sigmondkukla/rp2040-programmer-calculator/pcb/rp2040-programmer-calculator/rp2040-programmer-calculator.kicad_pcb

## KiCad design pcb/rp2040-programmer-calculator/rp2040-programmer-calculator.kicad_pcb (2025-03-18)

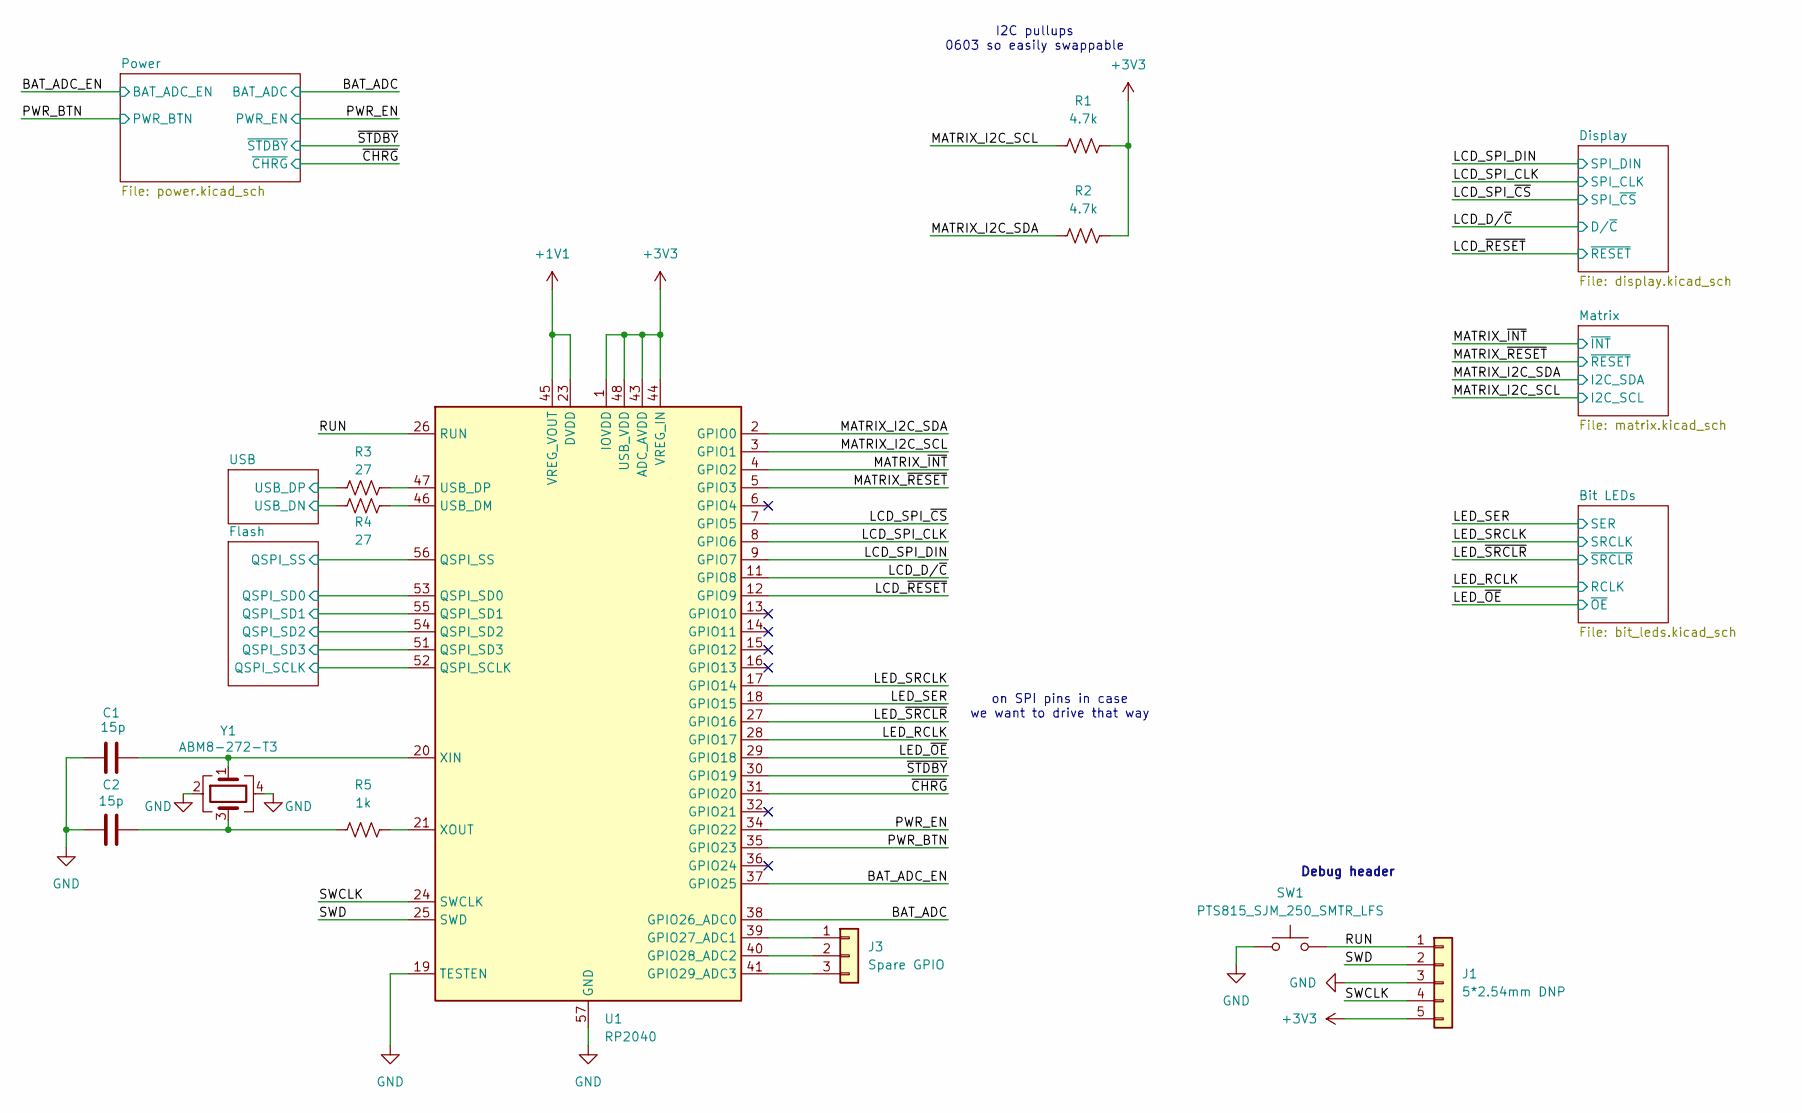
[picture p1: schematic rp2040-programmer-calculator.kicad_sch]

Parts:
C1, C2: 15p; C_0402_1005Metric; LCSC C1548
J1: 5*2.54mm DNP; PinHeader_1x05_P2.54mm_Vertical
J3: Spare GPIO; PinHeader_1x03_P2.00mm_Vertical
R1, R2: 4.7k; R_0603_1608Metric
R3, R4: 27; R_0402_1005Metric
R5: 1k; R_0402_1005Metric
SW1: PTS815_SJM_250_SMTR_LFS; SW_Push_PTS815_SJM_250_SMTR_LFS
U1: RP2040; QFN-56-1EP_7x7mm_P0.4mm_EP3.2x3.2mm
Y1: ABM8-272-T3; Crystal_SMD_Abracon_ABM8G-4Pin_3.2x2.5mm; LCSC C20625731

Connections:
+1V1: U1.23 (DVDD), U1.45 (VREG_VOUT), U1.50 (DVDD); also elsewhere on the board
+3V3: J1.5, R1.2, R2.2, U1.1 (IOVDD), U1.10 (IOVDD), U1.22 (IOVDD), U1.33 (IOVDD), U1.42 (IOVDD), U1.43 (ADC_AVDD), U1.44 (VREG_IN), U1.48 (USB_VDD), U1.49 (IOVDD); also elsewhere on the board
/BAT_ADC: U1.38 (GPIO26_ADC0); also elsewhere on the board
/BAT_ADC_EN: U1.37 (GPIO25); also elsewhere on the board
/Flash/QSPI_SCLK: U1.52 (QSPI_SCLK); also elsewhere on the board
/Flash/QSPI_SD0: U1.53 (QSPI_SD0); also elsewhere on the board
/Flash/QSPI_SD1: U1.55 (QSPI_SD1); also elsewhere on the board
/Flash/QSPI_SD2: U1.54 (QSPI_SD2); also elsewhere on the board
/Flash/QSPI_SD3: U1.51 (QSPI_SD3); also elsewhere on the board
/Flash/QSPI_SS: U1.56 (QSPI_SS); also elsewhere on the board
/LCD_D/~C: U1.11 (GPIO8); also elsewhere on the board
/LCD_SPI_CLK: U1.8 (GPIO6); also elsewhere on the board
/LCD_SPI_DIN: U1.9 (GPIO7); also elsewhere on the board
/LCD_SPI_~CS: U1.7 (GPIO5); also elsewhere on the board
/LCD_~RESET: U1.12 (GPIO9); also elsewhere on the board
/LED_RCLK: U1.28 (GPIO17); also elsewhere on the board
/LED_SER: U1.18 (GPIO15); also elsewhere on the board
/LED_SRCLK: U1.17 (GPIO14); also elsewhere on the board
/LED_~OE: U1.29 (GPIO18); also elsewhere on the board
/LED_~SRCLR: U1.27 (GPIO16); also elsewhere on the board
/MATRIX_I2C_SCL: R1.1, U1.3 (GPIO1); also elsewhere on the board
/MATRIX_I2C_SDA: R2.1, U1.2 (GPIO0); also elsewhere on the board
/MATRIX_~INT: U1.4 (GPIO2); also elsewhere on the board
/MATRIX_~RESET: U1.5 (GPIO3); also elsewhere on the board
/PWR_BTN: U1.35 (GPIO23); also elsewhere on the board
/PWR_EN: U1.34 (GPIO22); also elsewhere on the board
/RUN: J1.1, SW1.2, U1.26 (RUN)
/SWCLK: J1.4, U1.24 (SWCLK)
/SWD: J1.2, U1.25 (SWD)
/USB/USB_DN: R4.1; also elsewhere on the board
/USB/USB_DP: R3.1; also elsewhere on the board
/~CHRG: U1.31 (GPIO20); also elsewhere on the board
/~STDBY: U1.30 (GPIO19); also elsewhere on the board
GND: C1.1, C2.1, J1.3, SW1.1, U1.19 (TESTEN), U1.57 (GND), Y1.2, Y1.4; also elsewhere on the board
unnamed: C2.2, R5.1, Y1.3
unnamed: J3.1, U1.39 (GPIO27_ADC1)
unnamed: J3.2, U1.40 (GPIO28_ADC2)
unnamed: J3.3, U1.41 (GPIO29_ADC3)
unnamed: R4.2, U1.46 (USB_DM)
unnamed: R3.2, U1.47 (USB_DP)
unnamed: C1.2, U1.20 (XIN), Y1.1
unnamed: R5.2, U1.21 (XOUT)

Notes on the sheet:
I2C pullups 0603 so easily swappable
on SPI pins in case we want to drive that way
Debug header

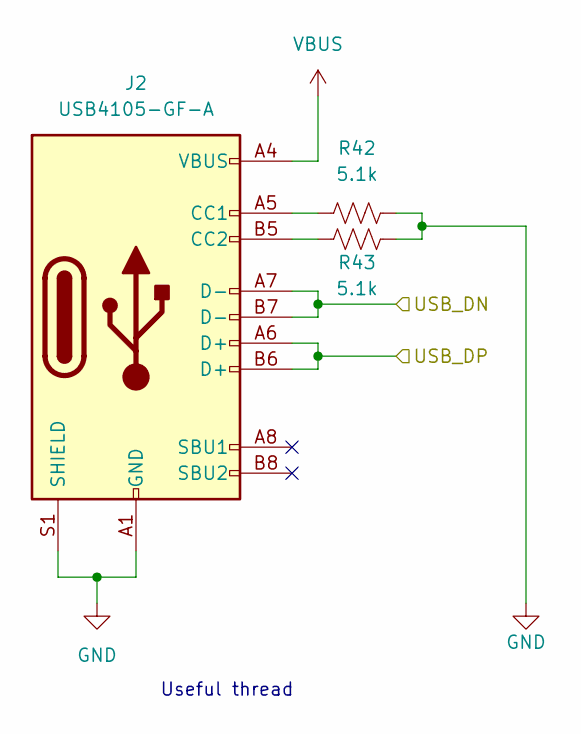
[picture p2: schematic usb.kicad_sch]

Parts:
J2: USB4105-GF-A; USB_C_Receptacle_GCT_USB4105-xx-A_16P_TopMnt_Horizontal
R42, R43: 5.1k; R_0603_1608Metric

Connections:
/USB/USB_DN: J2.A7 (D-), J2.B7 (D-); also elsewhere on the board
/USB/USB_DP: J2.A6 (D+), J2.B6 (D+); also elsewhere on the board
GND: J2.A1 (GND), J2.A12 (GND), J2.B1 (GND), J2.B12 (GND), J2.S1 (SHIELD), R42.2, R43.2; also elsewhere on the board
unnamed: J2.A5 (CC1), R42.1
unnamed: J2.B5 (CC2), R43.1
VBUS: J2.A4 (VBUS), J2.A9 (VBUS), J2.B4 (VBUS), J2.B9 (VBUS); also elsewhere on the board

Notes on the sheet:
Useful thread

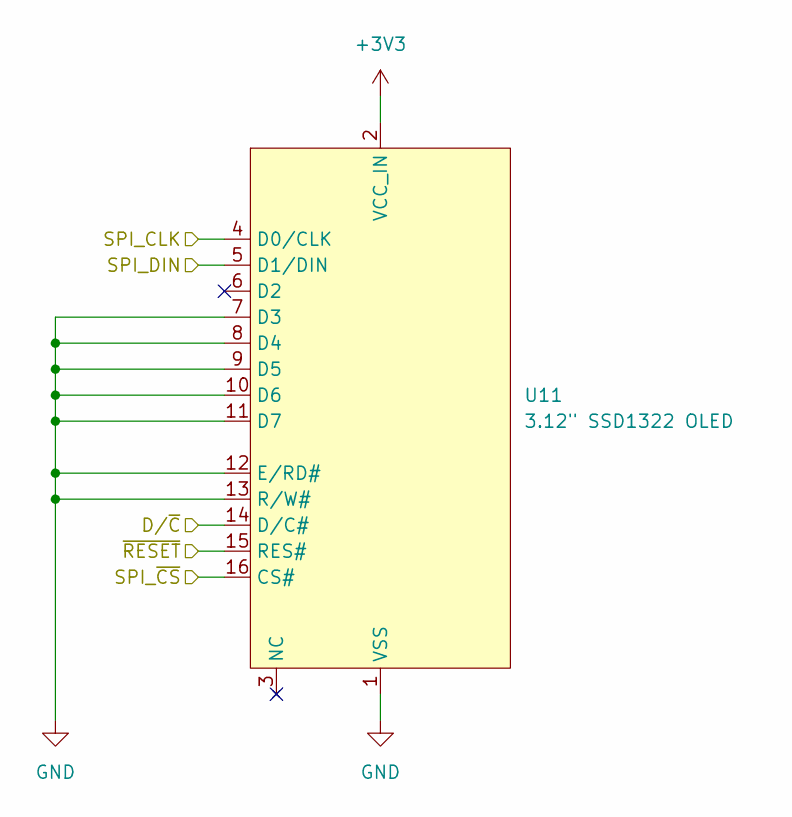
[picture p3: schematic display.kicad_sch]

Parts:
U11: 3.12" SSD1322 OLED; SSD1322_OLED

Connections:
+3V3: U11.2 (VCC_IN); also elsewhere on the board
/LCD_D/~C: U11.14 (D/C#); also elsewhere on the board
/LCD_SPI_CLK: U11.4 (D0/CLK); also elsewhere on the board
/LCD_SPI_DIN: U11.5 (D1/DIN); also elsewhere on the board
/LCD_SPI_~CS: U11.16 (CS#); also elsewhere on the board
/LCD_~RESET: U11.15 (RES#); also elsewhere on the board
GND: U11.1 (VSS), U11.7 (D3), U11.8 (D4), U11.9 (D5), U11.10 (D6), U11.11 (D7), U11.12 (E/RD#), U11.13 (R/W#); also elsewhere on the board

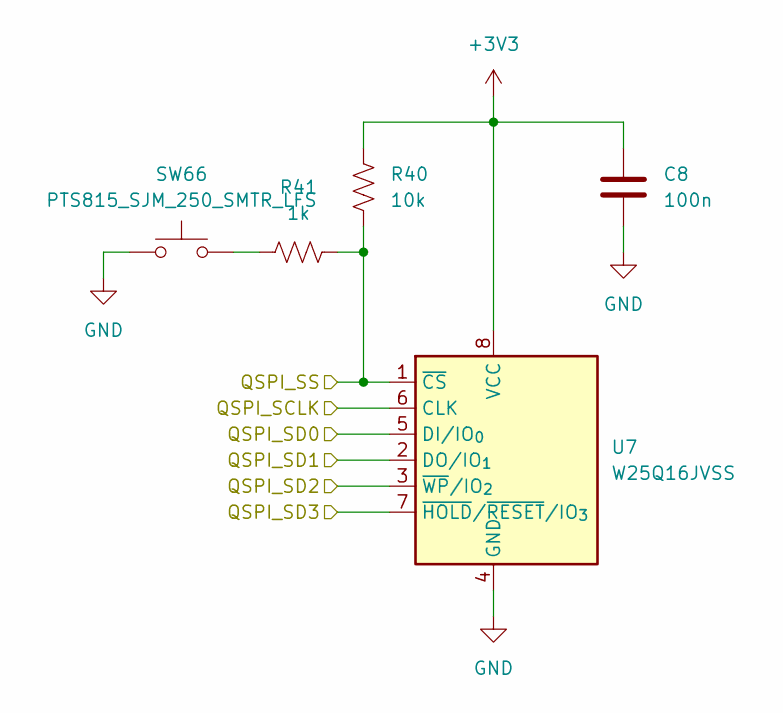
[picture p4: schematic flash.kicad_sch]

Parts:
C8: 100n; C_0603_1608Metric
R40: 10k; R_0603_1608Metric
R41: 1k; R_0603_1608Metric
SW66: PTS815_SJM_250_SMTR_LFS; SW_Push_PTS815_SJM_250_SMTR_LFS
U7: W25Q16JVSS; SOIC-8_5.3x5.3mm_P1.27mm

Connections:
+3V3: C8.1, R40.1, U7.8 (VCC); also elsewhere on the board
/Flash/QSPI_SCLK: U7.6 (CLK); also elsewhere on the board
/Flash/QSPI_SD0: U7.5 (DI/IO_{0}); also elsewhere on the board
/Flash/QSPI_SD1: U7.2 (DO/IO_{1}); also elsewhere on the board
/Flash/QSPI_SD2: U7.3 (~WP/IO_{2}); also elsewhere on the board
/Flash/QSPI_SD3: U7.7 (~HOLD/~RESET/IO_{3}); also elsewhere on the board
/Flash/QSPI_SS: R40.2, R41.2, U7.1 (~CS); also elsewhere on the board
GND: C8.2, SW66.1, U7.4 (GND); also elsewhere on the board
unnamed: R41.1, SW66.2

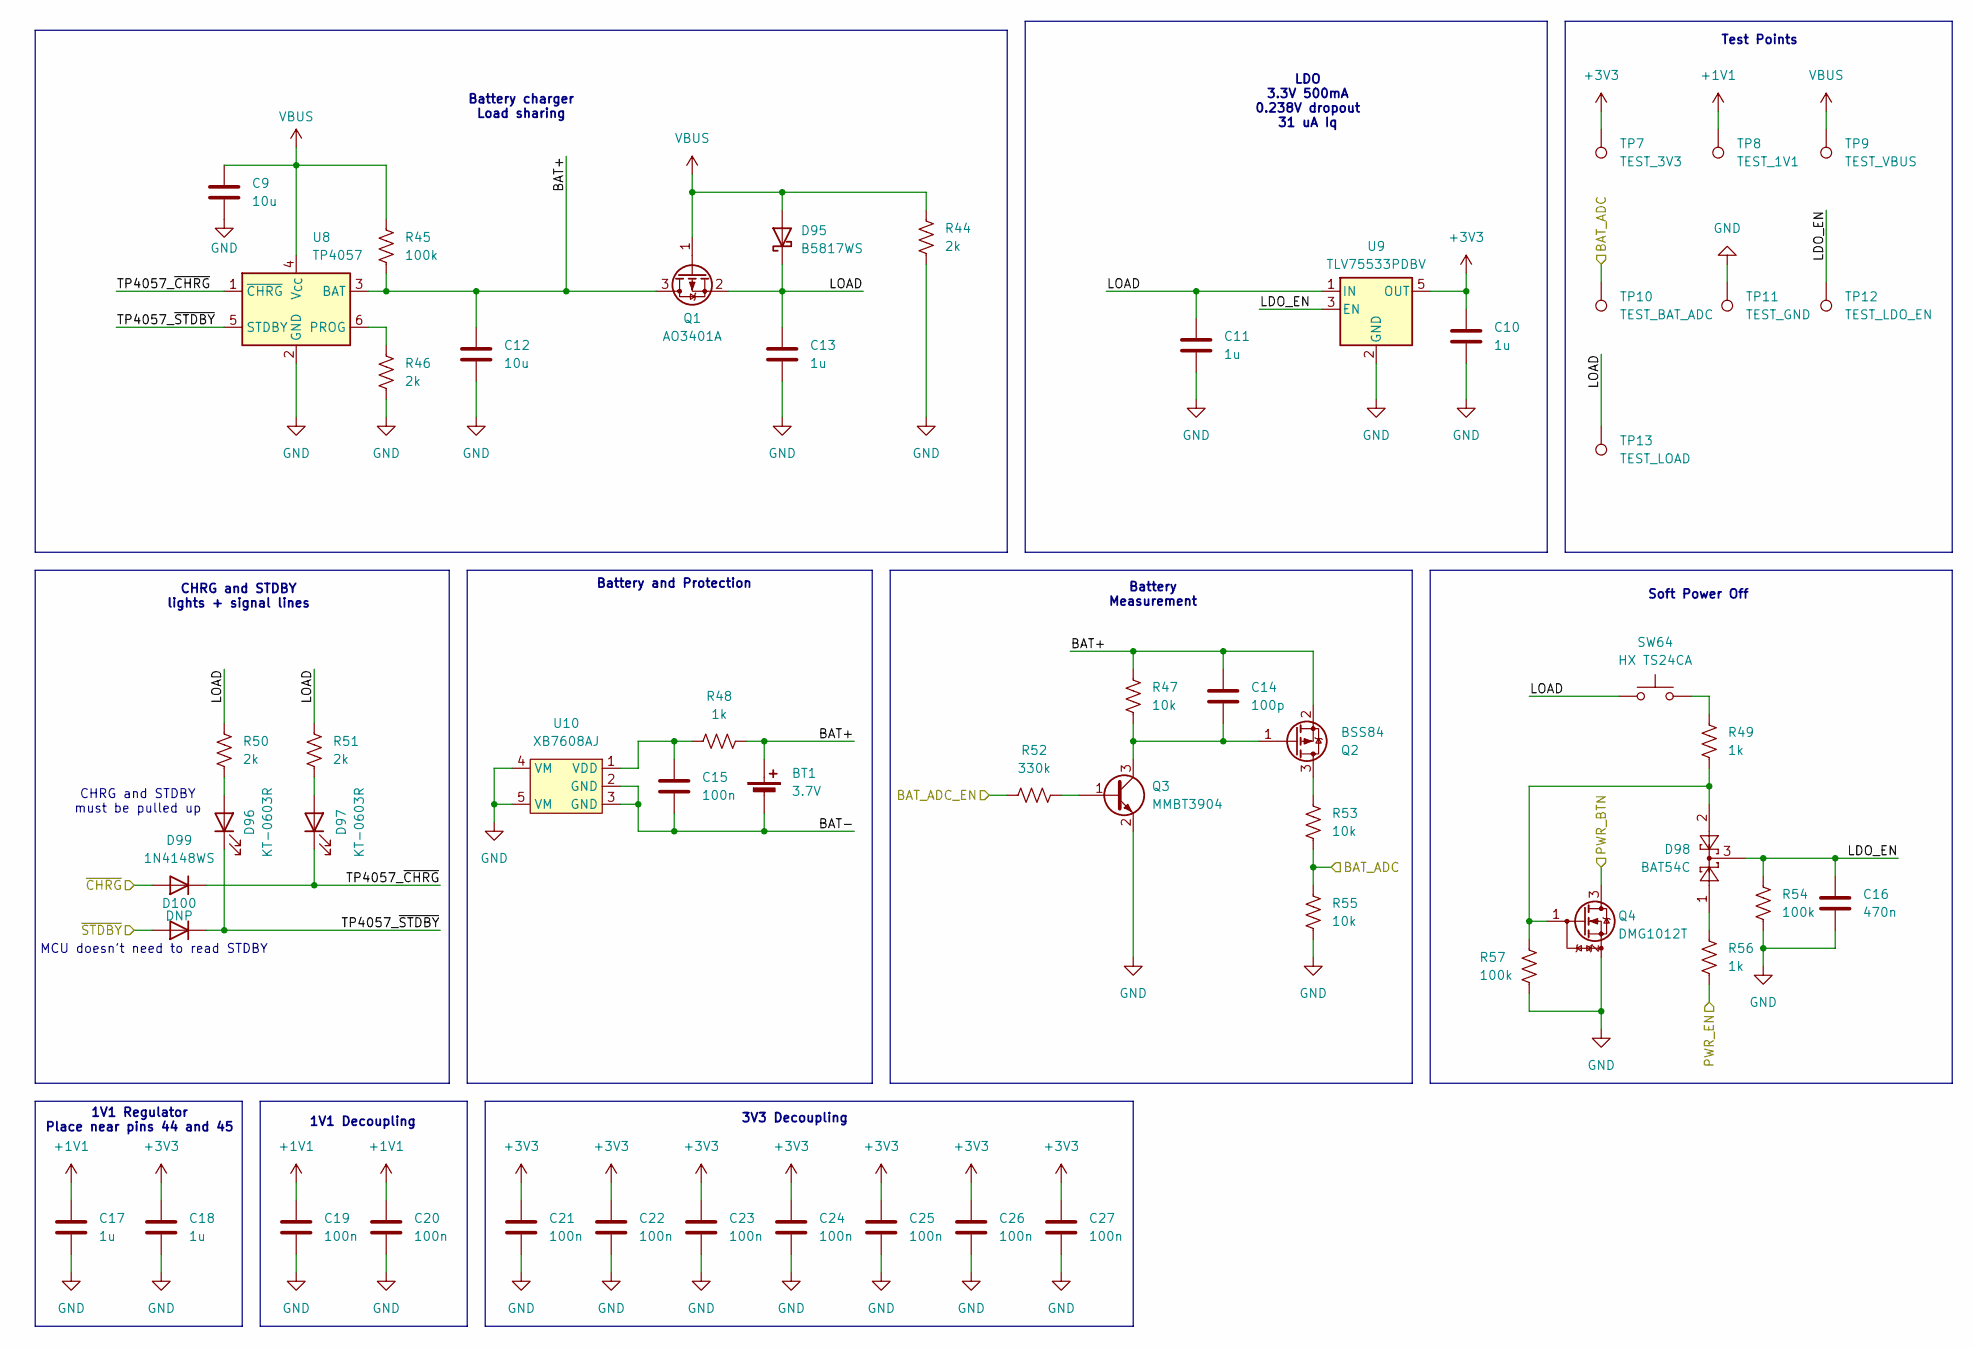
[picture p5: schematic power.kicad_sch]

Parts:
BT1: 3.7V; JST_PH_S2B-PH-K_1x02_P2.00mm_Horizontal
C9, C12: 10u; C_0603_1608Metric
C10, C11: 1u; C_0603_1608Metric; LCSC C52923
C13: 1u; C_0603_1608Metric
C14: 100p; C_0603_1608Metric
C15: 100n; C_0603_1608Metric
C16: 470n; C_0603_1608Metric
C17, C18: 1u; C_0402_1005Metric; LCSC C52923
C19, C20, C21, C22, C23, C24, C25, C26, C27: 100n; C_0402_1005Metric; LCSC C1525
D95: B5817WS; D_SOD-323
D96, D97: KT-0603R; LED_0603_1608Metric
D98: BAT54C; SOT-23-3
D99: 1N4148WS; D_SOD-323
D100: DNP; D_SOD-323
Q1: AO3401A; SOT-23-3
Q2: BSS84; SOT-23-3
Q3: MMBT3904; SOT-23
Q4: DMG1012T; SOT-523
R44, R46, R50, R51: 2k; R_0603_1608Metric
R45, R54, R57: 100k; R_0603_1608Metric
R47, R53, R55: 10k; R_0603_1608Metric
R48, R49, R56: 1k; R_0603_1608Metric
R52: 330k; R_0603_1608Metric
SW64: HX TS24CA; HX-TS24CA
TP7: TEST_3V3; TestPoint_Pad_D1.0mm
TP8: TEST_1V1; TestPoint_Pad_D1.0mm
TP9: TEST_VBUS; TestPoint_Pad_D1.0mm
TP10: TEST_BAT_ADC; TestPoint_Pad_D1.0mm
TP11: TEST_GND; TestPoint_Pad_D1.0mm
TP12: TEST_LDO_EN; TestPoint_Pad_D1.0mm
TP13: TEST_LOAD; TestPoint_Pad_D1.0mm
U8: TP4057; TSOT-23-6
U9: TLV75533PDBV; SOT-23-5
U10: XB7608AJ; CPC-5_L2.6-W2.6-P0.53-LS4.0-BL

Connections:
+1V1: C17.1, C19.1, C20.1, TP8.1; also elsewhere on the board
+3V3: C10.1, C18.1, C21.1, C22.1, C23.1, C24.1, C25.1, C26.1, C27.1, TP7.1, U9.5 (OUT); also elsewhere on the board
/BAT_ADC: R53.1, R55.2, TP10.1; also elsewhere on the board
/BAT_ADC_EN: R52.1; also elsewhere on the board
/PWR_BTN: Q4.3 (D); also elsewhere on the board
/PWR_EN: R56.2; also elsewhere on the board
/Power/BAT+: BT1.1 (+), C12.1, C14.1, Q1.3 (D), Q2.2 (S), R45.2, R47.2, R48.2, U8.3 (BAT)
/Power/BAT-: BT1.2 (-), C15.2, U10.2 (GND), U10.3 (GND)
/Power/LDO_EN: C16.1, D98.3, R54.1, TP12.1, U9.3 (EN)
/Power/LOAD: C11.1, C13.1, D95.1 (K), Q1.2 (S), R50.1, R51.1, SW64.2, TP13.1, U9.1 (IN)
/Power/TP4057_~CHRG: D97.1 (K), D99.1 (K), U8.1 (~CHRG)
/Power/TP4057_~STDBY: D96.1 (K), D100.1 (K), U8.5 (STDBY)
/~CHRG: D99.2 (A); also elsewhere on the board
/~STDBY: D100.2 (A); also elsewhere on the board
GND: C9.2, C10.2, C11.2, C12.2, C13.2, C16.2, C17.2, C18.2, C19.2, C20.2, C21.2, C22.2, C23.2, C24.2, C25.2, C26.2, C27.2, Q3.2 (E), Q4.2 (S), R44.2, R46.2, R54.2, R55.1, R57.2, TP11.1, U8.2 (GND), U9.2 (GND), U10.4 (VM), U10.5 (VM); also elsewhere on the board
unnamed: D96.2 (A), R50.2
unnamed: D97.2 (A), R51.2
unnamed: D98.1, R56.1
unnamed: Q2.3 (D), R53.2
unnamed: C14.2, Q2.1 (G), Q3.3 (C), R47.1
unnamed: Q3.1 (B), R52.2
unnamed: D98.2, Q4.1 (G), R49.2, R57.1
unnamed: R49.1, SW64.1
unnamed: R46.1, U8.6 (PROG)
unnamed: C15.1, R48.1, U10.1 (VDD)
VBUS: C9.1, D95.2 (A), Q1.1 (G), R44.1, R45.1, TP9.1, U8.4 (V_{CC}); also elsewhere on the board

Notes on the sheet:
MCU doesn't need to read STDBY
Battery Measurement
CHRG and STDBY lights + signal lines
CHRG and STDBY must be pulled up
LDO 3.3V 500mA 0.238V dropout 31 uA Iq
Test Points
3V3 Decoupling
Battery charger Load sharing
Soft Power Off
Battery and Protection
1V1 Regulator Place near pins 44 and 45
1V1 Decoupling

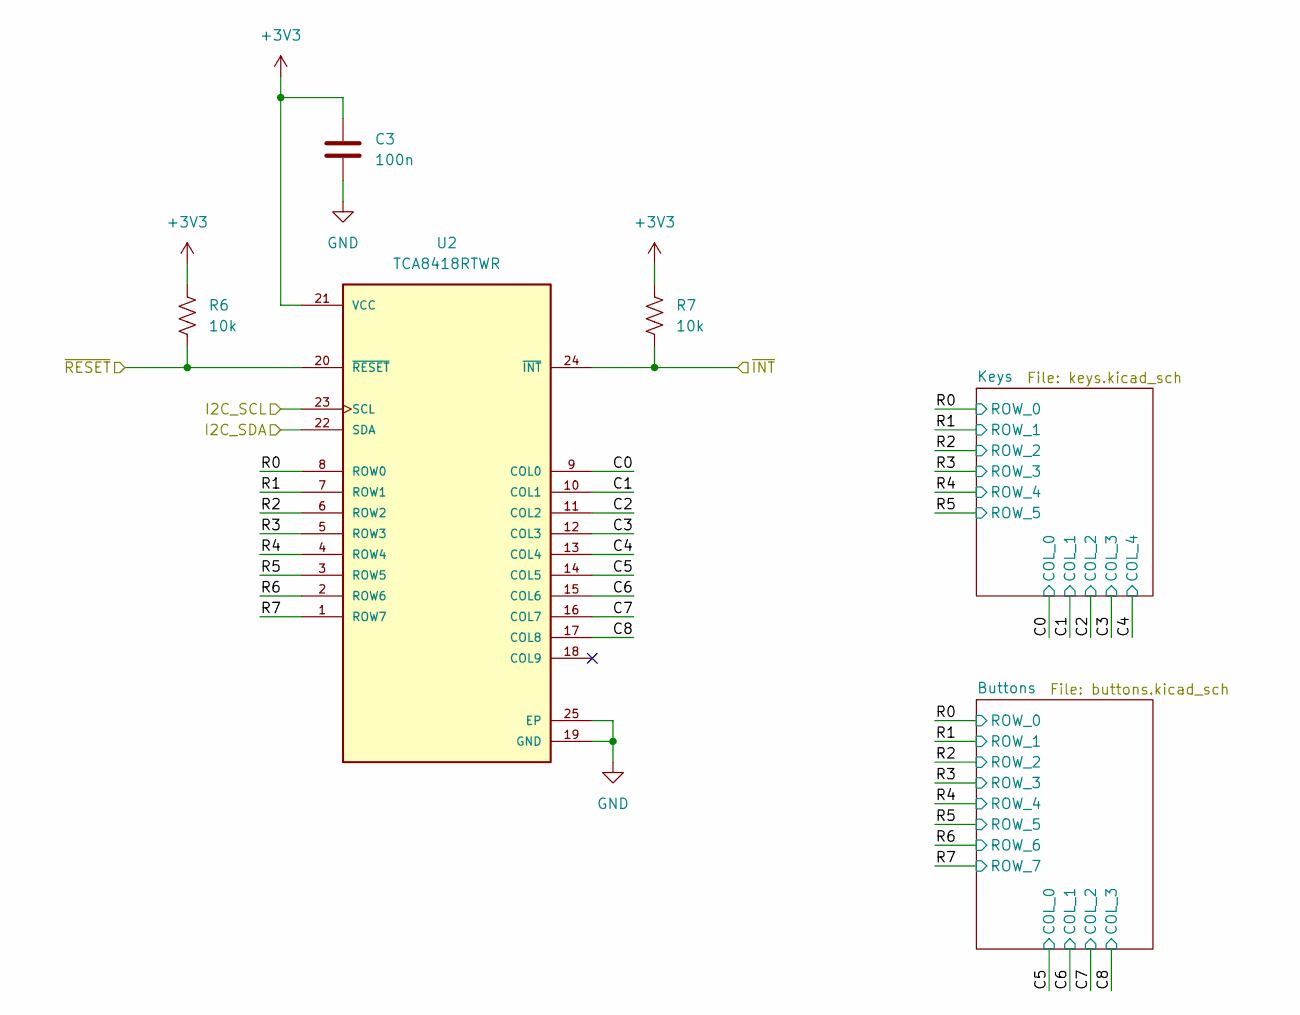
[picture p6: schematic matrix.kicad_sch]

Parts:
C3: 100n; C_0603_1608Metric
R6, R7: 10k; R_0603_1608Metric
U2: TCA8418RTWR; QFN50P400X400X80-25N; PARTREV G

Connections:
+3V3: C3.1, R6.1, R7.1, U2.21 (VCC); also elsewhere on the board
/MATRIX_I2C_SCL: U2.23 (SCL); also elsewhere on the board
/MATRIX_I2C_SDA: U2.22 (SDA); also elsewhere on the board
/MATRIX_~INT: R7.2, U2.24 (~INT); also elsewhere on the board
/MATRIX_~RESET: R6.2, U2.20 (~RESET); also elsewhere on the board
/Matrix/C0: U2.9 (COL0); also elsewhere on the board
/Matrix/C1: U2.10 (COL1); also elsewhere on the board
/Matrix/C2: U2.11 (COL2); also elsewhere on the board
/Matrix/C3: U2.12 (COL3); also elsewhere on the board
/Matrix/C4: U2.13 (COL4); also elsewhere on the board
/Matrix/C5: U2.14 (COL5); also elsewhere on the board
/Matrix/C6: U2.15 (COL6); also elsewhere on the board
/Matrix/C7: U2.16 (COL7); also elsewhere on the board
/Matrix/C8: U2.17 (COL8); also elsewhere on the board
/Matrix/R0: U2.8 (ROW0); also elsewhere on the board
/Matrix/R1: U2.7 (ROW1); also elsewhere on the board
/Matrix/R2: U2.6 (ROW2); also elsewhere on the board
/Matrix/R3: U2.5 (ROW3); also elsewhere on the board
/Matrix/R4: U2.4 (ROW4); also elsewhere on the board
/Matrix/R5: U2.3 (ROW5); also elsewhere on the board
/Matrix/R6: U2.2 (ROW6); also elsewhere on the board
/Matrix/R7: U2.1 (ROW7); also elsewhere on the board
GND: C3.2, U2.19 (GND), U2.25 (EP); also elsewhere on the board

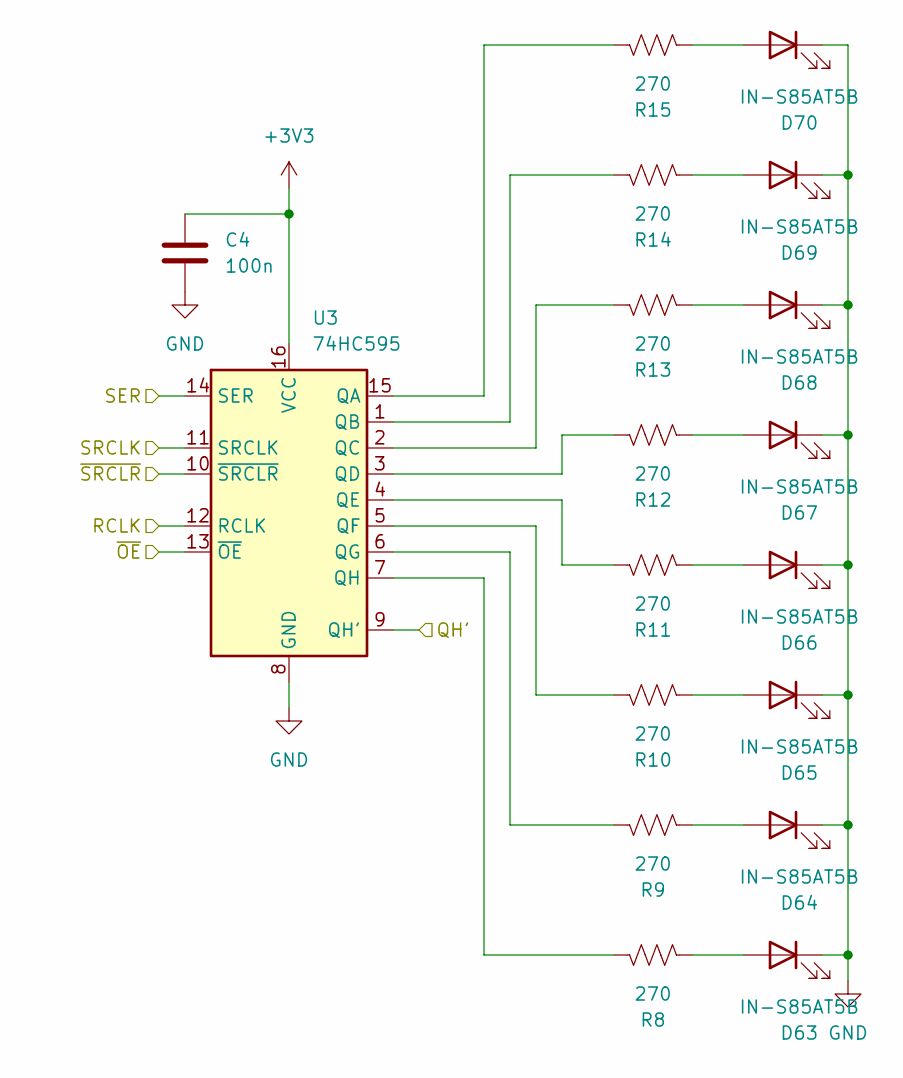
[picture p7: schematic led_byte.kicad_sch]

Parts:
C4: 100n; C_0603_1608Metric
D63, D64, D65, D66, D67, D68, D69, D70: IN-S85AT5B; LED_0805_2012Metric_Pad1.15x1.40mm_HandSolder
R8, R9, R10, R11, R12, R13, R14, R15: 270; R_0603_1608Metric_Pad0.98x0.95mm_HandSolder
U3: 74HC595; SOIC-16_3.9x9.9mm_P1.27mm

Connections:
+3V3: C4.1, U3.16 (VCC); also elsewhere on the board
/Bit LEDs/BYTE_0_OUT: U3.9 (QH'); also elsewhere on the board
/LED_RCLK: U3.12 (RCLK); also elsewhere on the board
/LED_SER: U3.14 (SER); also elsewhere on the board
/LED_SRCLK: U3.11 (SRCLK); also elsewhere on the board
/LED_~OE: U3.13 (~OE); also elsewhere on the board
/LED_~SRCLR: U3.10 (~SRCLR); also elsewhere on the board
GND: C4.2, D63.1 (K), D64.1 (K), D65.1 (K), D66.1 (K), D67.1 (K), D68.1 (K), D69.1 (K), D70.1 (K), U3.8 (GND); also elsewhere on the board
unnamed: D63.2 (A), R8.2
unnamed: D64.2 (A), R9.2
unnamed: D65.2 (A), R10.2
unnamed: D66.2 (A), R11.2
unnamed: D67.2 (A), R12.2
unnamed: D68.2 (A), R13.2
unnamed: D69.2 (A), R14.2
unnamed: D70.2 (A), R15.2
unnamed: R15.1, U3.15 (QA)
unnamed: R14.1, U3.1 (QB)
unnamed: R13.1, U3.2 (QC)
unnamed: R12.1, U3.3 (QD)
unnamed: R11.1, U3.4 (QE)
unnamed: R10.1, U3.5 (QF)
unnamed: R9.1, U3.6 (QG)
unnamed: R8.1, U3.7 (QH)

Parts of its further copies:
C5, C6, C7: 100n; C_0603_1608Metric
D71, D72, D73, D74, D75, D76, D77, D78, D79, D80, D81, D82, D83, D84, D85, D86, D87, D88, D89, D90, D91, D92, D93, D94: IN-S85AT5B; LED_0805_2012Metric_Pad1.15x1.40mm_HandSolder
R16, R17, R18, R19, R20, R21, R22, R23, R24, R25, R26, R27, R28, R29, R30, R31, R32, R33, R34, R35, R36, R37, R38, R39: 270; R_0603_1608Metric_Pad0.98x0.95mm_HandSolder
U4, U5, U6: 74HC595; SOIC-16_3.9x9.9mm_P1.27mm

Connections of its further copies:
+3V3: C5.1, C6.1, C7.1, U4.16 (VCC), U5.16 (VCC), U6.16 (VCC); also elsewhere on the board
/Bit LEDs/BYTE_0_OUT: U4.14 (SER); also elsewhere on the board
/Bit LEDs/BYTE_1_OUT: U4.9 (QH'), U5.14 (SER)
/Bit LEDs/BYTE_2_OUT: U5.9 (QH'), U6.14 (SER)
/Bit LEDs/LED_Byte_3/QH&apos;: U6.9 (QH')
/LED_RCLK: U4.12 (RCLK), U5.12 (RCLK), U6.12 (RCLK); also elsewhere on the board
/LED_SRCLK: U4.11 (SRCLK), U5.11 (SRCLK), U6.11 (SRCLK); also elsewhere on the board
/LED_~OE: U4.13 (~OE), U5.13 (~OE), U6.13 (~OE); also elsewhere on the board
/LED_~SRCLR: U4.10 (~SRCLR), U5.10 (~SRCLR), U6.10 (~SRCLR); also elsewhere on the board
GND: C5.2, C6.2, C7.2, D71.1 (K), D72.1 (K), D73.1 (K), D74.1 (K), D75.1 (K), D76.1 (K), D77.1 (K), D78.1 (K), D79.1 (K), D80.1 (K), D81.1 (K), D82.1 (K), D83.1 (K), D84.1 (K), D85.1 (K), D86.1 (K), D87.1 (K), D88.1 (K), D89.1 (K), D90.1 (K), D91.1 (K), D92.1 (K), D93.1 (K), D94.1 (K), U4.8 (GND), U5.8 (GND), U6.8 (GND); also elsewhere on the board
unnamed: D71.2 (A), R16.2
unnamed: D72.2 (A), R17.2
unnamed: D73.2 (A), R18.2
unnamed: D74.2 (A), R19.2
unnamed: D75.2 (A), R20.2
unnamed: D76.2 (A), R21.2
unnamed: D77.2 (A), R22.2
unnamed: D78.2 (A), R23.2
unnamed: D79.2 (A), R24.2
unnamed: D80.2 (A), R25.2
unnamed: D81.2 (A), R26.2
unnamed: D82.2 (A), R27.2
unnamed: D83.2 (A), R28.2
unnamed: D84.2 (A), R29.2
unnamed: D85.2 (A), R30.2
unnamed: D86.2 (A), R31.2
unnamed: D87.2 (A), R32.2
unnamed: D88.2 (A), R33.2
unnamed: D89.2 (A), R34.2
unnamed: D90.2 (A), R35.2
unnamed: D91.2 (A), R36.2
unnamed: D92.2 (A), R37.2
unnamed: D93.2 (A), R38.2
unnamed: D94.2 (A), R39.2
unnamed: R23.1, U4.15 (QA)
unnamed: R22.1, U4.1 (QB)
unnamed: R21.1, U4.2 (QC)
unnamed: R20.1, U4.3 (QD)
unnamed: R19.1, U4.4 (QE)
unnamed: R18.1, U4.5 (QF)
unnamed: R17.1, U4.6 (QG)
unnamed: R16.1, U4.7 (QH)
unnamed: R31.1, U5.15 (QA)
unnamed: R30.1, U5.1 (QB)
unnamed: R29.1, U5.2 (QC)
unnamed: R28.1, U5.3 (QD)
unnamed: R27.1, U5.4 (QE)
unnamed: R26.1, U5.5 (QF)
unnamed: R25.1, U5.6 (QG)
unnamed: R24.1, U5.7 (QH)
unnamed: R39.1, U6.15 (QA)
unnamed: R38.1, U6.1 (QB)
unnamed: R37.1, U6.2 (QC)
unnamed: R36.1, U6.3 (QD)
unnamed: R35.1, U6.4 (QE)
unnamed: R34.1, U6.5 (QF)
unnamed: R33.1, U6.6 (QG)
unnamed: R32.1, U6.7 (QH)

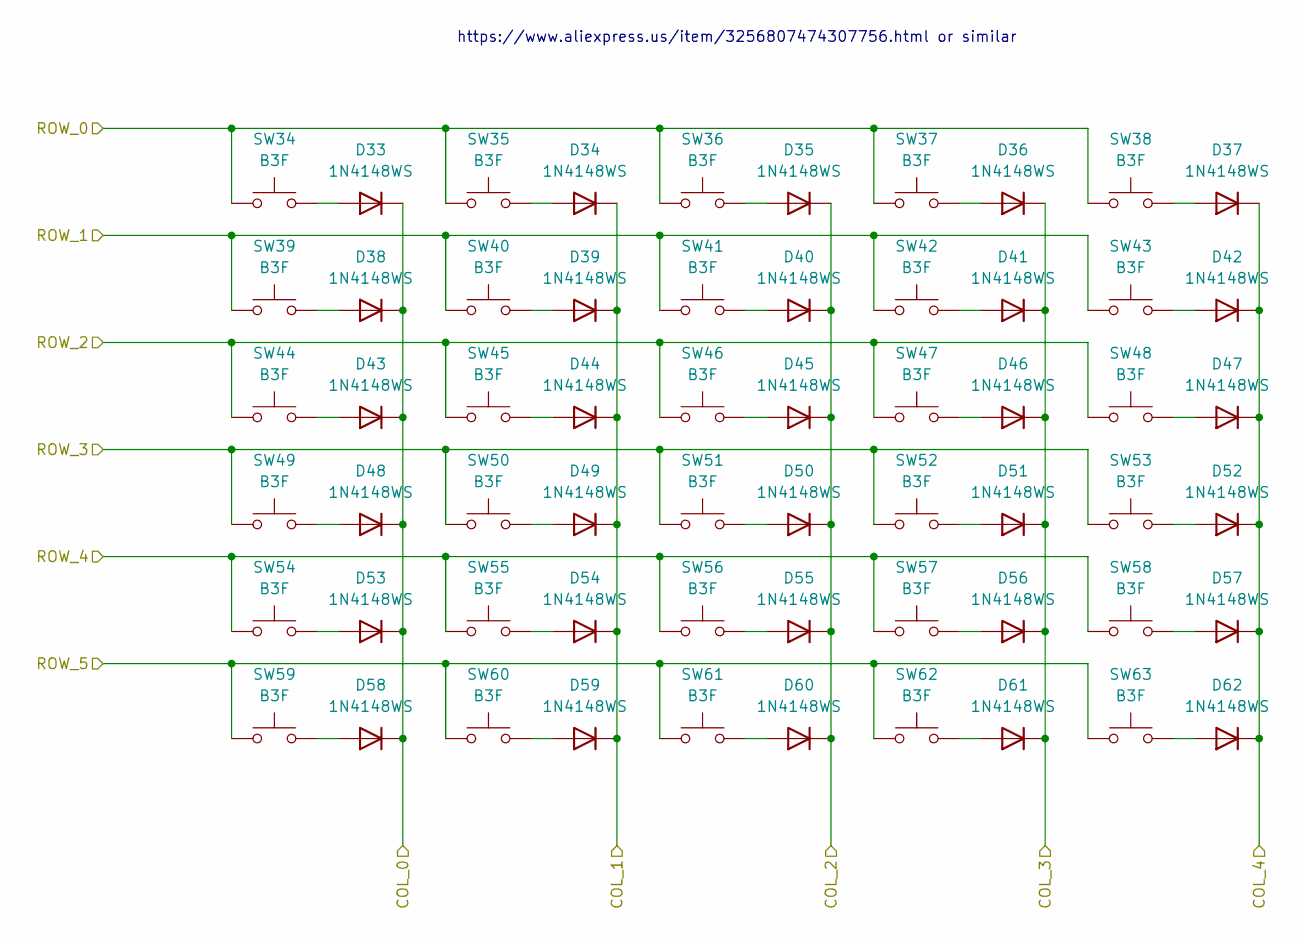
[picture p8: schematic keys.kicad_sch]

Parts:
D33, D34, D35, D36, D37, D38, D39, D40, D41, D42, D43, D44, D45, D46, D47, D48, D49, D50, D51, D52, D53, D54, D55, D56, D57, D58, D59, D60, D61, D62: 1N4148WS; D_SOD-323
SW34, SW35, SW36, SW37, SW38, SW39, SW40, SW41, SW42, SW43, SW44, SW45, SW46, SW47, SW48, SW49, SW50, SW51, SW52, SW53, SW54, SW55, SW56, SW57, SW58, SW59, SW60, SW61, SW62, SW63: B3F; SW_SPST_Omron_B3F-40xx

Connections:
/Matrix/C0: D33.1 (K), D38.1 (K), D43.1 (K), D48.1 (K), D53.1 (K), D58.1 (K); also elsewhere on the board
/Matrix/C1: D34.1 (K), D39.1 (K), D44.1 (K), D49.1 (K), D54.1 (K), D59.1 (K); also elsewhere on the board
/Matrix/C2: D35.1 (K), D40.1 (K), D45.1 (K), D50.1 (K), D55.1 (K), D60.1 (K); also elsewhere on the board
/Matrix/C3: D36.1 (K), D41.1 (K), D46.1 (K), D51.1 (K), D56.1 (K), D61.1 (K); also elsewhere on the board
/Matrix/C4: D37.1 (K), D42.1 (K), D47.1 (K), D52.1 (K), D57.1 (K), D62.1 (K); also elsewhere on the board
/Matrix/R0: SW34.1, SW35.1, SW36.1, SW37.1, SW38.1; also elsewhere on the board
/Matrix/R1: SW39.1, SW40.1, SW41.1, SW42.1, SW43.1; also elsewhere on the board
/Matrix/R2: SW44.1, SW45.1, SW46.1, SW47.1, SW48.1; also elsewhere on the board
/Matrix/R3: SW49.1, SW50.1, SW51.1, SW52.1, SW53.1; also elsewhere on the board
/Matrix/R4: SW54.1, SW55.1, SW56.1, SW57.1, SW58.1; also elsewhere on the board
/Matrix/R5: SW59.1, SW60.1, SW61.1, SW62.1, SW63.1; also elsewhere on the board
unnamed: D33.2 (A), SW34.2
unnamed: D34.2 (A), SW35.2
unnamed: D35.2 (A), SW36.2
unnamed: D36.2 (A), SW37.2
unnamed: D37.2 (A), SW38.2
unnamed: D38.2 (A), SW39.2
unnamed: D39.2 (A), SW40.2
unnamed: D40.2 (A), SW41.2
unnamed: D41.2 (A), SW42.2
unnamed: D42.2 (A), SW43.2
unnamed: D43.2 (A), SW44.2
unnamed: D44.2 (A), SW45.2
unnamed: D45.2 (A), SW46.2
unnamed: D46.2 (A), SW47.2
unnamed: D47.2 (A), SW48.2
unnamed: D48.2 (A), SW49.2
unnamed: D49.2 (A), SW50.2
unnamed: D50.2 (A), SW51.2
unnamed: D51.2 (A), SW52.2
unnamed: D52.2 (A), SW53.2
unnamed: D53.2 (A), SW54.2
unnamed: D54.2 (A), SW55.2
unnamed: D55.2 (A), SW56.2
unnamed: D56.2 (A), SW57.2
unnamed: D57.2 (A), SW58.2
unnamed: D58.2 (A), SW59.2
unnamed: D59.2 (A), SW60.2
unnamed: D60.2 (A), SW61.2
unnamed: D61.2 (A), SW62.2
unnamed: D62.2 (A), SW63.2

Notes on the sheet:
https://www.aliexpress.us/item/3256807474307756.html or similar

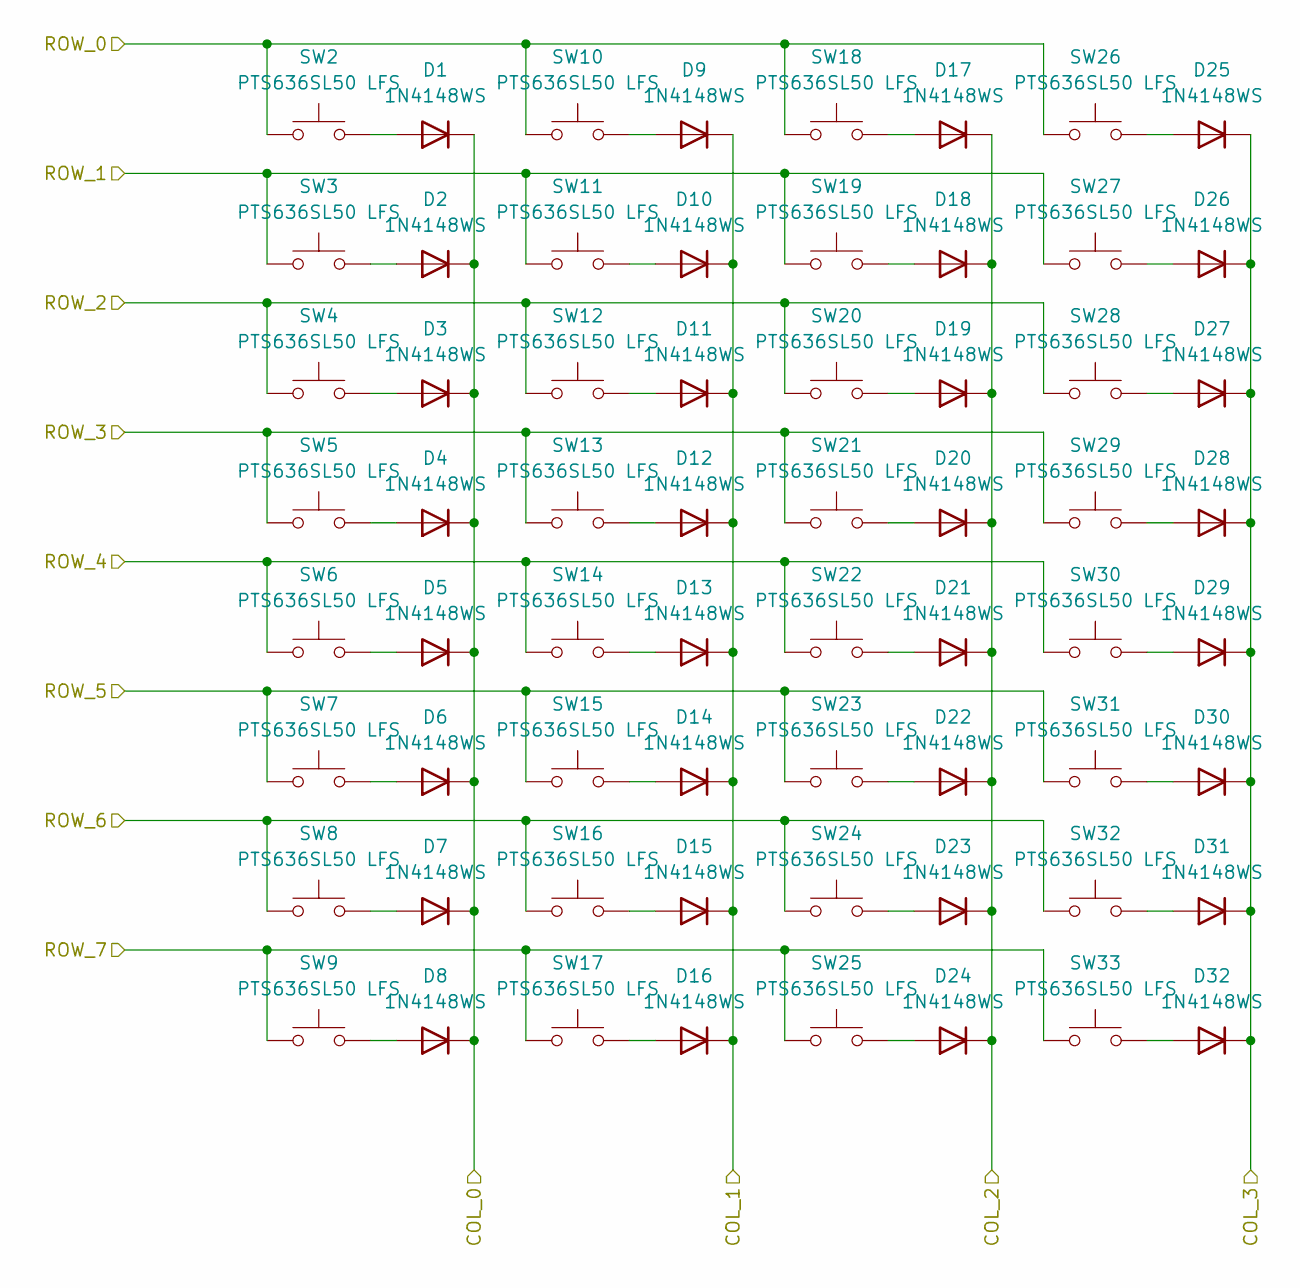
[picture p9: schematic buttons.kicad_sch]

Parts:
D1, D2, D3, D4, D5, D6, D7, D8, D9, D10, D11, D12, D13, D14, D15, D16, D17, D18, D19, D20, D21, D22, D23, D24, D25, D26, D27, D28, D29, D30, D31, D32: 1N4148WS; D_SOD-323
SW2, SW3, SW4, SW5, SW6, SW7, SW8, SW9, SW10, SW11, SW12, SW13, SW14, SW15, SW16, SW17, SW18, SW19, SW20, SW21, SW22, SW23, SW24, SW25, SW26, SW27, SW28, SW29, SW30, SW31, SW32, SW33: PTS636SL50 LFS; PTS636SL50LFS

Connections:
/Matrix/C5: D1.1 (K), D2.1 (K), D3.1 (K), D4.1 (K), D5.1 (K), D6.1 (K), D7.1 (K), D8.1 (K); also elsewhere on the board
/Matrix/C6: D9.1 (K), D10.1 (K), D11.1 (K), D12.1 (K), D13.1 (K), D14.1 (K), D15.1 (K), D16.1 (K); also elsewhere on the board
/Matrix/C7: D17.1 (K), D18.1 (K), D19.1 (K), D20.1 (K), D21.1 (K), D22.1 (K), D23.1 (K), D24.1 (K); also elsewhere on the board
/Matrix/C8: D25.1 (K), D26.1 (K), D27.1 (K), D28.1 (K), D29.1 (K), D30.1 (K), D31.1 (K), D32.1 (K); also elsewhere on the board
/Matrix/R0: SW2.1, SW10.1, SW18.1, SW26.1; also elsewhere on the board
/Matrix/R1: SW3.1, SW11.1, SW19.1, SW27.1; also elsewhere on the board
/Matrix/R2: SW4.1, SW12.1, SW20.1, SW28.1; also elsewhere on the board
/Matrix/R3: SW5.1, SW13.1, SW21.1, SW29.1; also elsewhere on the board
/Matrix/R4: SW6.1, SW14.1, SW22.1, SW30.1; also elsewhere on the board
/Matrix/R5: SW7.1, SW15.1, SW23.1, SW31.1; also elsewhere on the board
/Matrix/R6: SW8.1, SW16.1, SW24.1, SW32.1; also elsewhere on the board
/Matrix/R7: SW9.1, SW17.1, SW25.1, SW33.1; also elsewhere on the board
unnamed: D1.2 (A), SW2.2
unnamed: D2.2 (A), SW3.2
unnamed: D3.2 (A), SW4.2
unnamed: D4.2 (A), SW5.2
unnamed: D5.2 (A), SW6.2
unnamed: D6.2 (A), SW7.2
unnamed: D7.2 (A), SW8.2
unnamed: D8.2 (A), SW9.2
unnamed: D9.2 (A), SW10.2
unnamed: D10.2 (A), SW11.2
unnamed: D11.2 (A), SW12.2
unnamed: D12.2 (A), SW13.2
unnamed: D13.2 (A), SW14.2
unnamed: D14.2 (A), SW15.2
unnamed: D15.2 (A), SW16.2
unnamed: D16.2 (A), SW17.2
unnamed: D17.2 (A), SW18.2
unnamed: D18.2 (A), SW19.2
unnamed: D19.2 (A), SW20.2
unnamed: D20.2 (A), SW21.2
unnamed: D21.2 (A), SW22.2
unnamed: D22.2 (A), SW23.2
unnamed: D23.2 (A), SW24.2
unnamed: D24.2 (A), SW25.2
unnamed: D25.2 (A), SW26.2
unnamed: D26.2 (A), SW27.2
unnamed: D27.2 (A), SW28.2
unnamed: D28.2 (A), SW29.2
unnamed: D29.2 (A), SW30.2
unnamed: D30.2 (A), SW31.2
unnamed: D31.2 (A), SW32.2
unnamed: D32.2 (A), SW33.2
