sigmondkukla/rp2040-programmer-calculator/pcb/rp2040-programmer-calculator/rp2040-programmer-calculator.kicad_pcb

## KiCad design pcb/rp2040-programmer-calculator/rp2040-programmer-calculator.kicad_pcb (continued)

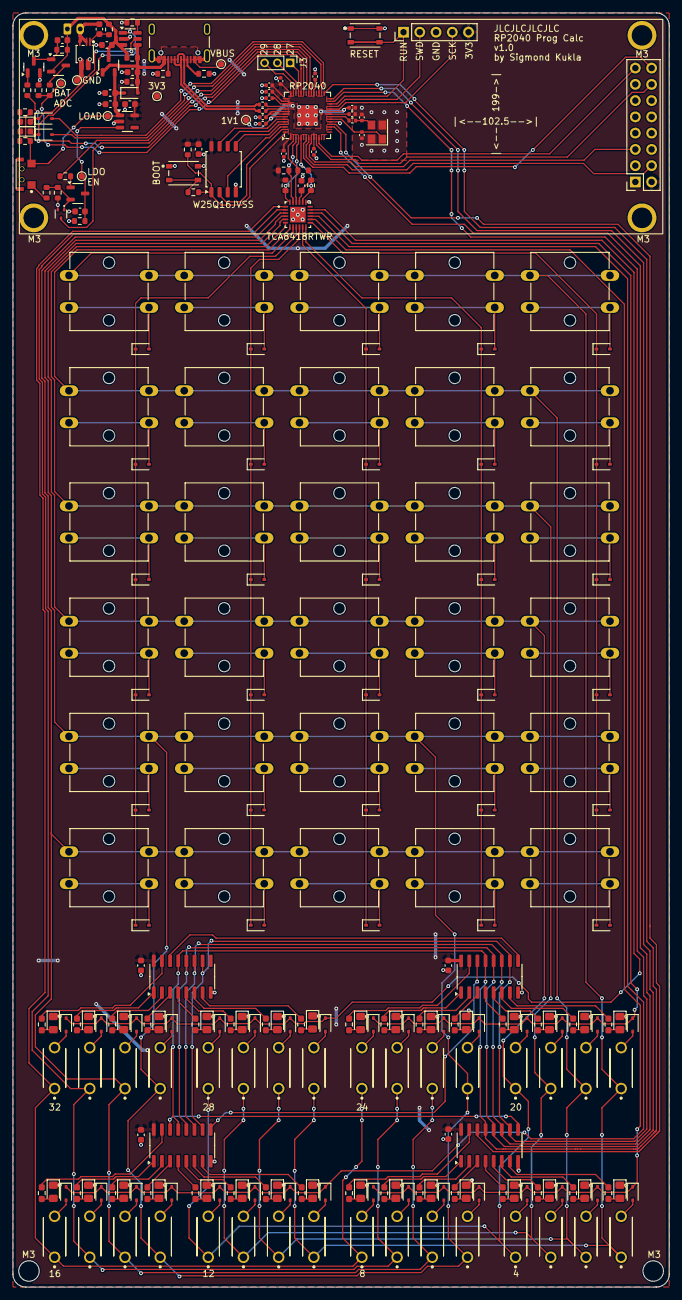
[picture p10: board rp2040-programmer-calculator.kicad_pcb from above]

Board: 2 copper layers, 102.5 x 199.0 mm, 276 parts (1 on the bottom side), 208 nets.
