sigmondkukla/rp2040-programmer-calculator/src/images.h

static const uint8_t image_status_charge_bits[] = {0x04,0x06,0x06,0x1f,0x0c,0x0c,0x04};
static const uint8_t image_status_battery_bits[] = {0xfe,0x07,0x01,0x08,0x01,0x18,0x01,0x18,0x01,0x18,0x01,0x08,0xfe,0x07};
static const uint8_t image_status_shift_bits[] = {0x08,0x1c,0x3e,0x7f,0x1c,0x1c,0x1c};
