sigmondkukla/rp2040-programmer-calculator/(commit log)

2025-01-18 Add KiCad gitignore
2025-01-27 Add schematics
    [bit_leds.kicad_sch, buttons.kicad_sch, flash.kicad_sch, keys.kicad_sch, led_byte.kicad_sch, matrix.kicad_sch, power.kicad_sch, rp2040-programmer-calculator.kicad_pcb]
2025-01-27 Finish schematic
    [display.kicad_sch, flash.kicad_sch, rp2040-programmer-calculator.kicad_sch]
2025-01-30 Finish PCB
    [buttons.kicad_sch, display.kicad_sch, flash.kicad_sch, keys.kicad_sch, led_byte.kicad_sch, matrix.kicad_sch, power.kicad_sch, rp2040-programmer-calculator.kicad_pcb]
2025-03-16 Finished design
    [bit_leds.kicad_sch, buttons.kicad_sch, display.kicad_sch, flash.kicad_sch, keys.kicad_sch, led_byte.kicad_sch, matrix.kicad_sch, power.kicad_sch]
2025-03-18 Add RP2040 project
    [power.kicad_sch, rp2040-programmer-calculator.kicad_pcb]
2025-03-21 Add TCA8418 driver
2025-03-21 Add pin and port defs
2025-03-21 Add bit leds shift register driver
2025-03-21 Add bit leds init
2025-03-21 Setup soft power init and latching
